varunsunkara15/Nexus_drive/hardware/nexus_drive.kicad_pcb

## KiCad design hardware/nexus_drive.kicad_pcb (2026-11-03)

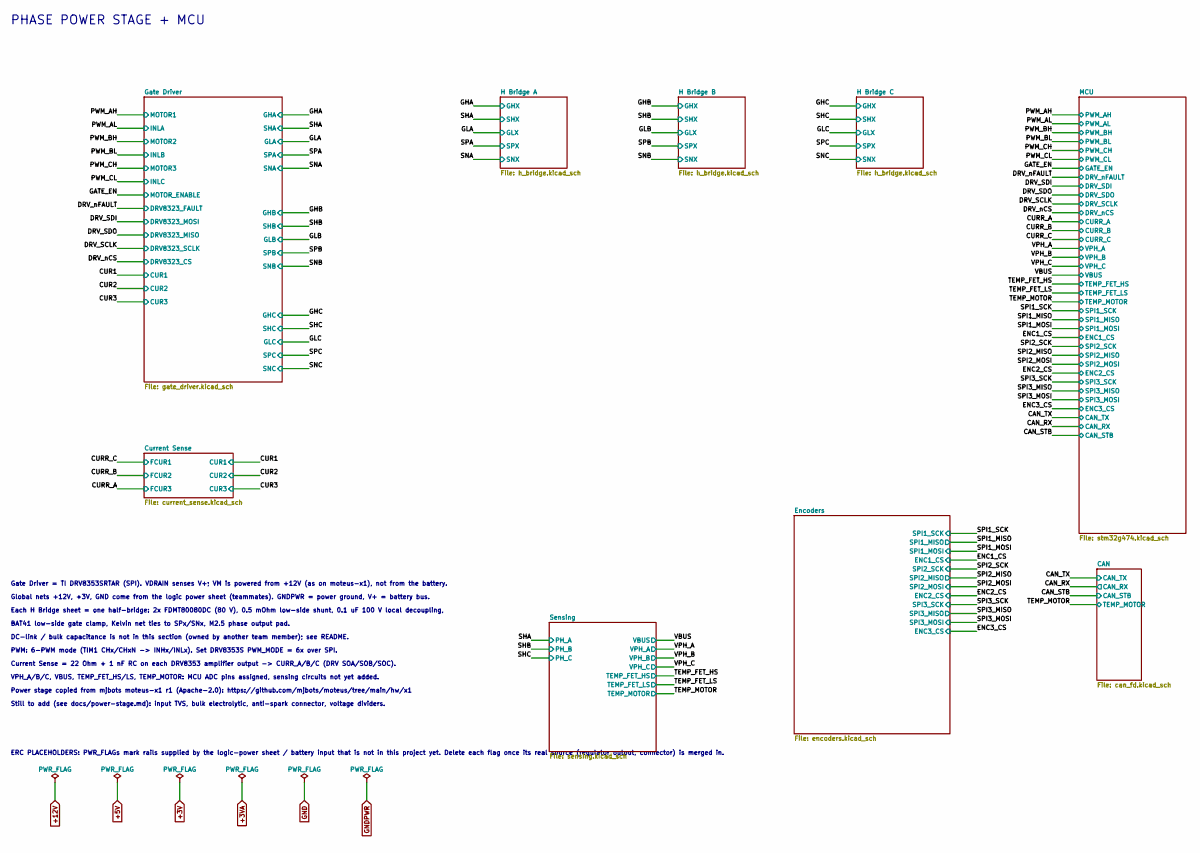
[picture p1: schematic nexus_drive.kicad_sch, Nexus Drive]

Notes on the sheet:
PWM: 6-PWM mode (TIM1 CHx/CHxN -> INHx/INLx). Set DRV8353S PWM_MODE = 6x over SPI.
Each H Bridge sheet = one half-bridge: 2x FDMT80080DC (80 V), 0.5 mOhm low-side shunt, 0.1 uF 100 V local decoupling,
Global nets +12V, +3V, GND come from the logic power sheet (teammates). GNDPWR = power ground, V+ = battery bus.
Gate Driver = TI DRV8353SRTAR (SPI). VDRAIN senses V+; VM is powered from +12V (as on moteus-x1), not from the battery.
DC-link / bulk capacitance is not in this section (owned by another team member); see README.
BAT41 low-side gate clamp, Kelvin net ties to SPx/SNx, M2.5 phase output pad.
Power stage copied from mjbots moteus-x1 r1 (Apache-2.0): https://github.com/mjbots/moteus/tree/main/hw/x1
Current Sense = 22 Ohm + 1 nF RC on each DRV8353 amplifier output -> CURR_A/B/C (DRV SOA/SOB/SOC).
ERC PLACEHOLDERS: PWR_FLAGs mark rails supplied by the logic-power sheet / battery input that is not in this project yet. Delete each flag once its real source (regulator output, connector) is merged in.
PHASE POWER STAGE + MCU
VPH_A/B/C, VBUS, TEMP_FET_HS/LS, TEMP_MOTOR: MCU ADC pins assigned, sensing circuits not yet added.
Still to add (see docs/power-stage.md): input TVS, bulk electrolytic, anti-spark connector, voltage dividers.

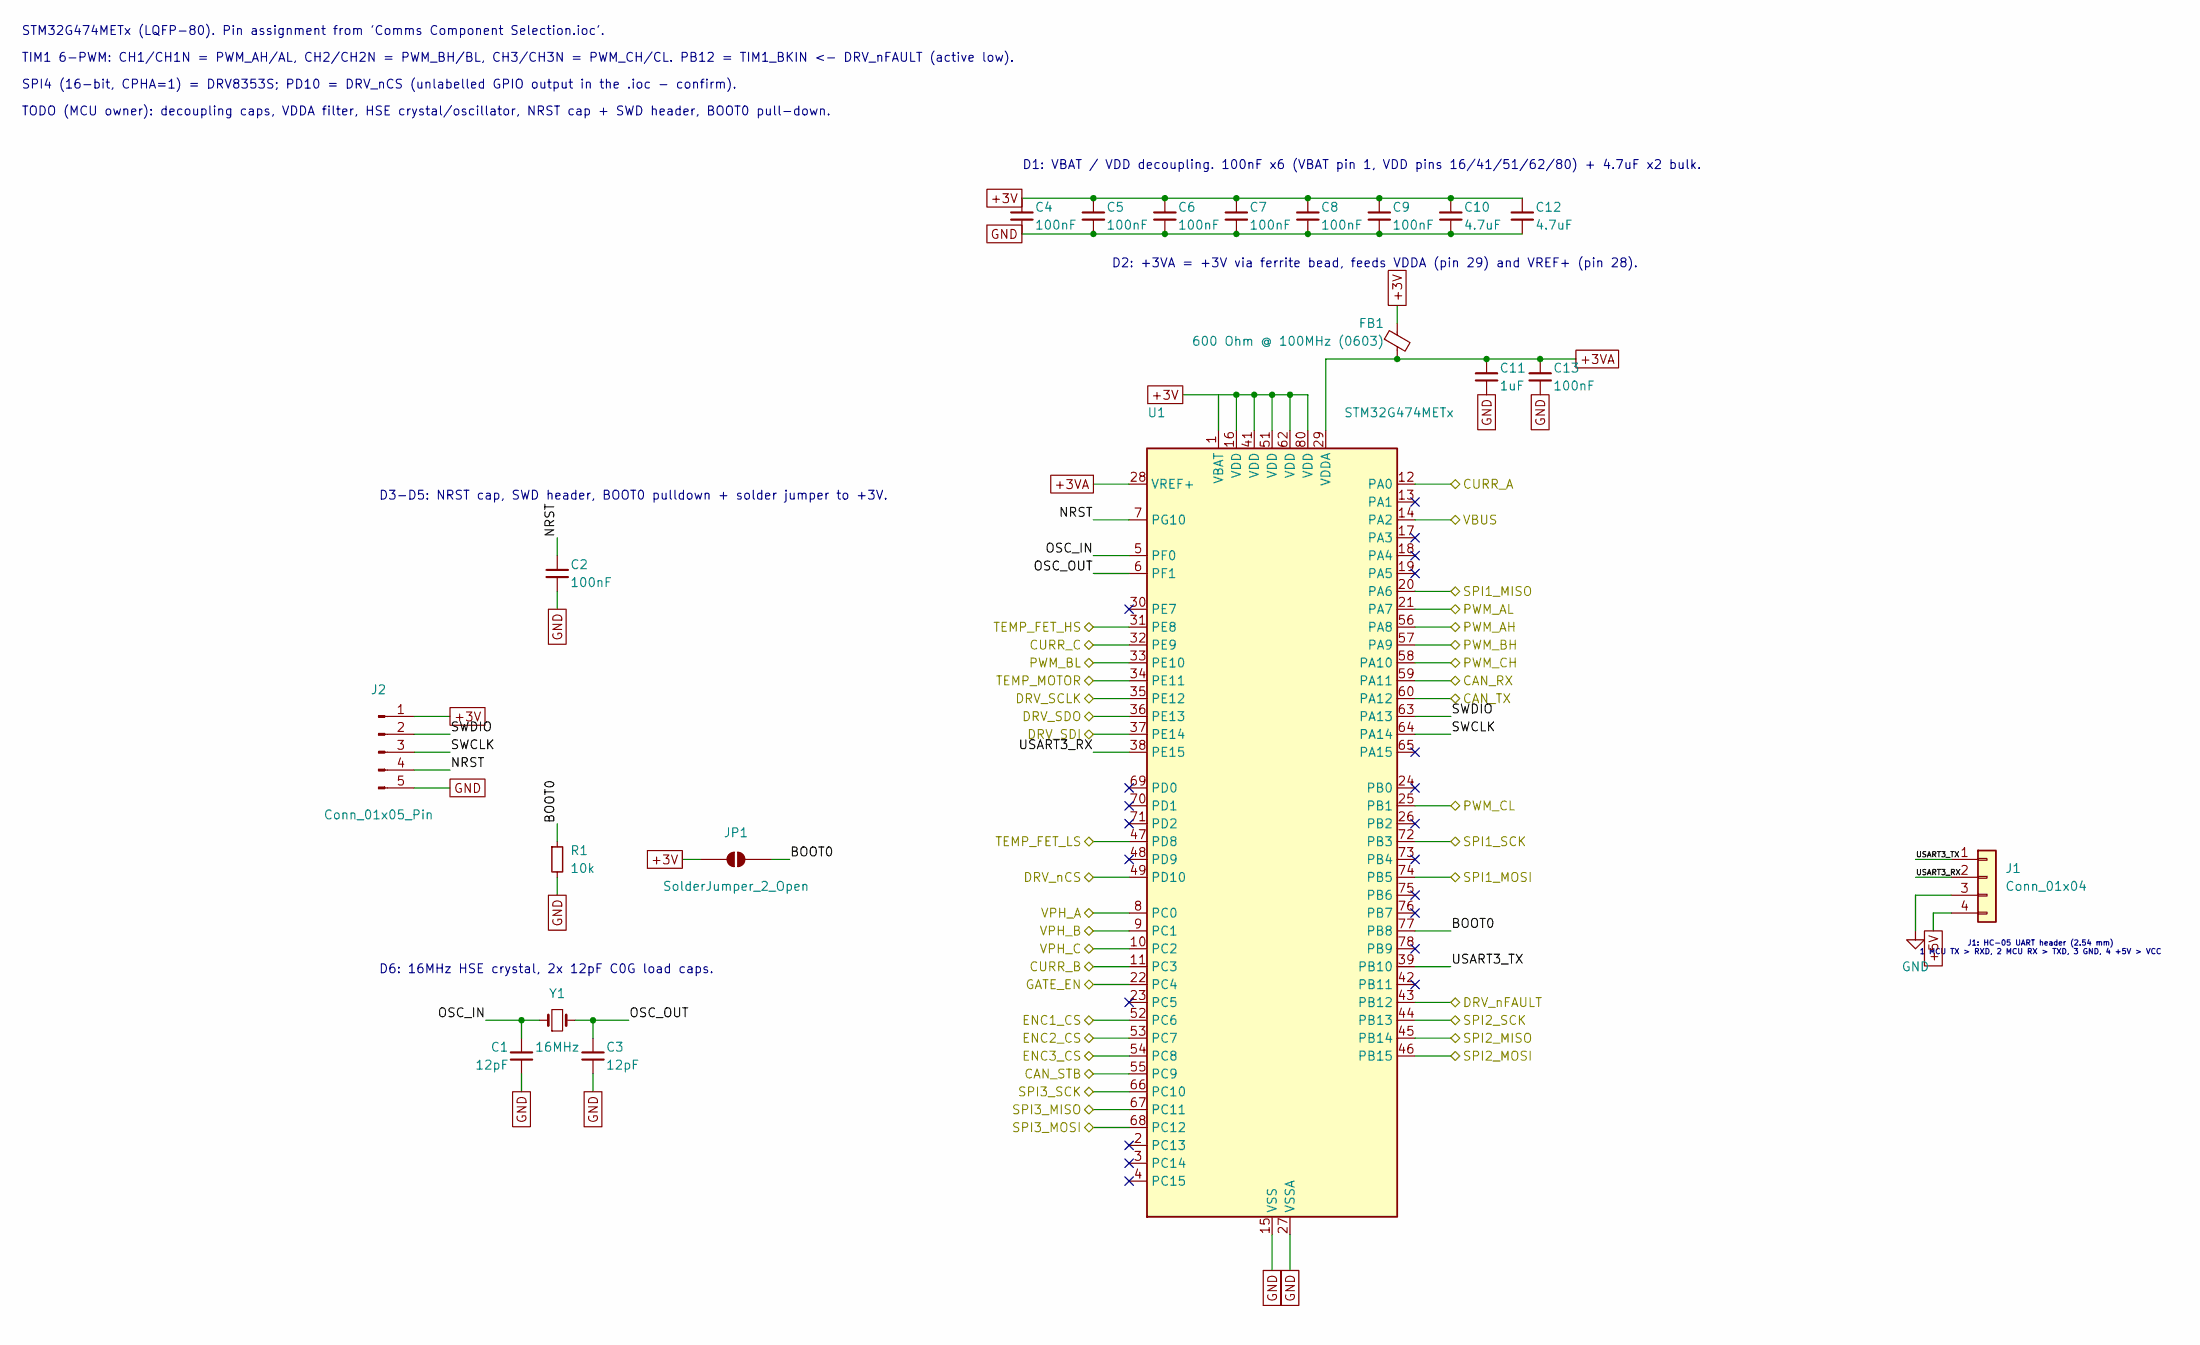
[picture p2: schematic stm32g474.kicad_sch, Nexus Drive - MCU (STM32G474METx)]

Parts:
C1, C3: 12pF; C_0603_1608Metric
C2, C4, C5, C6, C7, C8, C9, C13: 100nF; C_0603_1608Metric
C10, C12: 4.7uF; C_0805_2012Metric
C11: 1uF; C_0603_1608Metric
FB1: 600 Ohm @ 100MHz (0603); L_0603_1608Metric
J1: Conn_01x04; PinHeader_1x04_P2.54mm_Vertical
J2: Conn_01x05_Pin; PinHeader_1x05_P1.27mm_Vertical
JP1: SolderJumper_2_Open; SolderJumper-2_P1.3mm_Open_Pad1.0x1.5mm
R1: 10k; R_0603_1608Metric
U1: STM32G474METx; LQFP-80_12x12mm_P0.5mm
Y1: 16MHz; Crystal_SMD_5032-2Pin_5.0x3.2mm; MPN ABM8-16.000MHZ-10-1-U-T

Connections:
+3V: C4.1, C5.1, C6.1, C7.1, C8.1, C9.1, C10.1, C12.1, FB1.1, J2.1, JP1.1 (A), U1.1 (VBAT), U1.16 (VDD), U1.41 (VDD), U1.51 (VDD), U1.62 (VDD), U1.80 (VDD); also elsewhere on the board
+3VA: C11.1, C13.1, FB1.2, U1.28 (VREF+), U1.29 (VDDA); also elsewhere on the board
+5V: J1.4; also elsewhere on the board
/CAN_RX: U1.59 (PA11); also elsewhere on the board
/CAN_STB: U1.55 (PC9); also elsewhere on the board
/CAN_TX: U1.60 (PA12); also elsewhere on the board
/CURR_A: U1.12 (PA0); also elsewhere on the board
/CURR_B: U1.11 (PC3); also elsewhere on the board
/CURR_C: U1.32 (PE9); also elsewhere on the board
/DRV_SCLK: U1.35 (PE12); also elsewhere on the board
/DRV_SDI: U1.37 (PE14); also elsewhere on the board
/DRV_SDO: U1.36 (PE13); also elsewhere on the board
/DRV_nCS: U1.49 (PD10); also elsewhere on the board
/DRV_nFAULT: U1.43 (PB12); also elsewhere on the board
/ENC1_CS: U1.52 (PC6); also elsewhere on the board
/ENC2_CS: U1.53 (PC7); also elsewhere on the board
/ENC3_CS: U1.54 (PC8); also elsewhere on the board
/GATE_EN: U1.22 (PC4); also elsewhere on the board
/MCU/BOOT0: JP1.2 (B), R1.1, U1.77 (PB8)
/MCU/NRST: C2.1, J2.4, U1.7 (PG10)
/MCU/OSC_IN: C1.1, U1.5 (PF0), Y1.1
/MCU/OSC_OUT: C3.1, U1.6 (PF1), Y1.2
/MCU/SWCLK: J2.3, U1.64 (PA14)
/MCU/SWDIO: J2.2, U1.63 (PA13)
/MCU/USART3_RX: J1.2, U1.38 (PE15)
/MCU/USART3_TX: J1.1, U1.39 (PB10)
/PWM_AH: U1.56 (PA8); also elsewhere on the board
/PWM_AL: U1.21 (PA7); also elsewhere on the board
/PWM_BH: U1.57 (PA9); also elsewhere on the board
/PWM_BL: U1.33 (PE10); also elsewhere on the board
/PWM_CH: U1.58 (PA10); also elsewhere on the board
/PWM_CL: U1.25 (PB1); also elsewhere on the board
/SPI1_MISO: U1.20 (PA6); also elsewhere on the board
/SPI1_MOSI: U1.74 (PB5); also elsewhere on the board
/SPI1_SCK: U1.72 (PB3); also elsewhere on the board
/SPI2_MISO: U1.45 (PB14); also elsewhere on the board
/SPI2_MOSI: U1.46 (PB15); also elsewhere on the board
/SPI2_SCK: U1.44 (PB13); also elsewhere on the board
/SPI3_MISO: U1.67 (PC11); also elsewhere on the board
/SPI3_MOSI: U1.68 (PC12); also elsewhere on the board
/SPI3_SCK: U1.66 (PC10); also elsewhere on the board
/TEMP_FET_HS: U1.31 (PE8); also elsewhere on the board
/TEMP_FET_LS: U1.47 (PD8); also elsewhere on the board
/TEMP_MOTOR: U1.34 (PE11); also elsewhere on the board
/VBUS: U1.14 (PA2); also elsewhere on the board
/VPH_A: U1.8 (PC0); also elsewhere on the board
/VPH_B: U1.9 (PC1); also elsewhere on the board
/VPH_C: U1.10 (PC2); also elsewhere on the board
GND: C1.2, C2.2, C3.2, C4.2, C5.2, C6.2, C7.2, C8.2, C9.2, C10.2, C11.2, C12.2, C13.2, J1.3, J2.5, R1.2, U1.15 (VSS), U1.27 (VSSA), U1.40 (VSS), U1.50 (VSS), U1.61 (VSS), U1.79 (VSS); also elsewhere on the board

Notes on the sheet:
D2: +3VA = +3V via ferrite bead, feeds VDDA (pin 29) and VREF+ (pin 28).
J1: HC-05 UART header (2.54 mm) 1 MCU TX > RXD, 2 MCU RX > TXD, 3 GND, 4 +5V > VCC
TODO (MCU owner): decoupling caps, VDDA filter, HSE crystal/oscillator, NRST cap + SWD header, BOOT0 pull-down.
SPI4 (16-bit, CPHA=1) = DRV8353S; PD10 = DRV_nCS (unlabelled GPIO output in the .ioc - confirm).
D1: VBAT / VDD decoupling. 100nF x6 (VBAT pin 1, VDD pins 16/41/51/62/80) + 4.7uF x2 bulk.
D6: 16MHz HSE crystal, 2x 12pF C0G load caps.
STM32G474METx (LQFP-80). Pin assignment from 'Comms Component Selection.ioc'.
TIM1 6-PWM: CH1/CH1N = PWM_AH/AL, CH2/CH2N = PWM_BH/BL, CH3/CH3N = PWM_CH/CL. PB12 = TIM1_BKIN <- DRV_nFAULT (active low).
D3-D5: NRST cap, SWD header, BOOT0 pulldown + solder jumper to +3V.

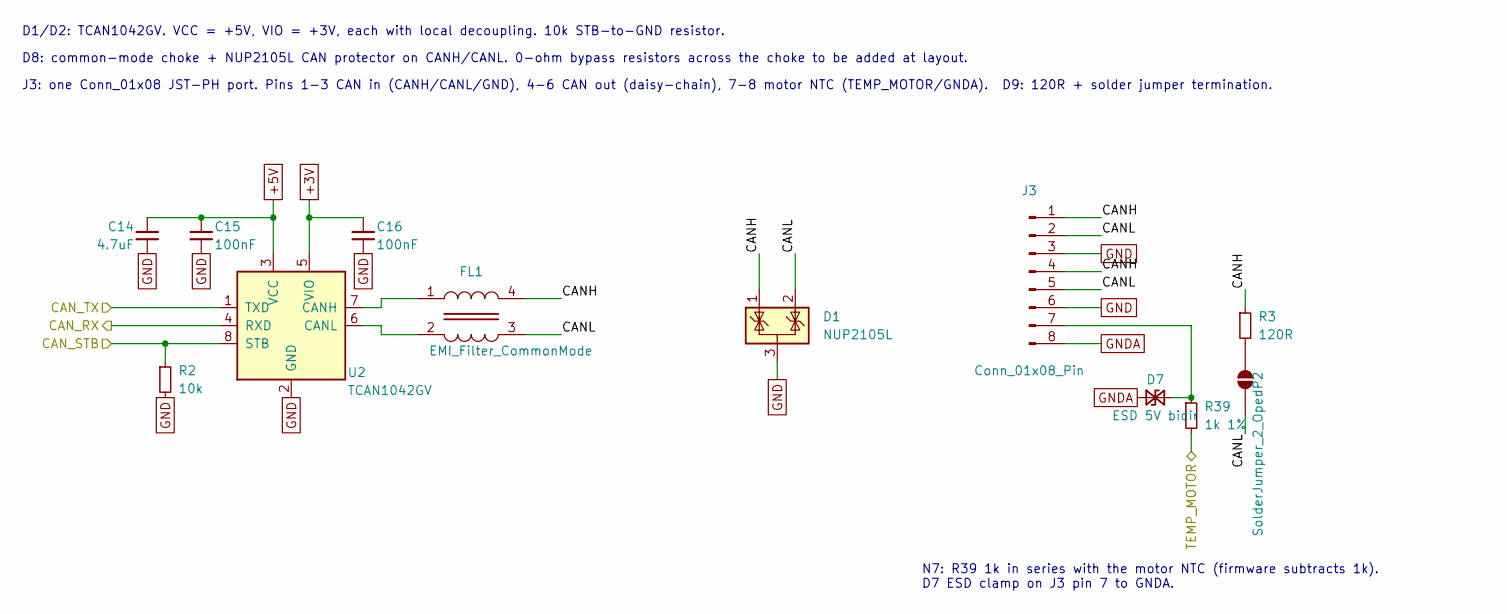
[picture p3: schematic can_fd.kicad_sch]

Parts:
C14: 4.7uF; C_0805_2012Metric
C15, C16: 100nF; C_0603_1608Metric
D1: NUP2105L; SOT-23
D7: ESD 5V bidir; D_SOD-323
FL1: EMI_Filter_CommonMode; L_CommonMode_TDK_ACT1210D
J3: Conn_01x08_Pin; JST_PH_B8B-PH-K_1x08_P2.00mm_Vertical
JP2: SolderJumper_2_Open; SolderJumper-2_P1.3mm_Open_Pad1.0x1.5mm
R2: 10k; R_0603_1608Metric
R3: 120R; R_0603_1608Metric
R39: 1k 1%; R_0603_1608Metric
U2: TCAN1042GV; SOIC-8_3.9x4.9mm_P1.27mm

Connections:
+3V: C16.1, U2.5 (VIO); also elsewhere on the board
+5V: C14.1, C15.1, U2.3 (VCC); also elsewhere on the board
/CAN/CANH: D1.1 (K), FL1.4, J3.1, J3.4, R3.1
/CAN/CANL: D1.2 (K), FL1.3, J3.2, J3.5, JP2.2 (B)
/CAN_RX: U2.4 (RXD); also elsewhere on the board
/CAN_STB: R2.1, U2.8 (STB); also elsewhere on the board
/CAN_TX: U2.1 (TXD); also elsewhere on the board
/TEMP_MOTOR: R39.2; also elsewhere on the board
GND: C14.2, C15.2, C16.2, D1.3 (A), J3.3, J3.6, R2.2, U2.2 (GND); also elsewhere on the board
GNDA: D7.1 (A1), J3.8; also elsewhere on the board
unnamed: D7.2 (A2), J3.7, R39.1
unnamed: JP2.1 (A), R3.2
unnamed: FL1.1, U2.7 (CANH)
unnamed: FL1.2, U2.6 (CANL)

Notes on the sheet:
D8: common-mode choke + NUP2105L CAN protector on CANH/CANL. 0-ohm bypass resistors across the choke to be added at layout.
D1/D2: TCAN1042GV. VCC = +5V, VIO = +3V, each with local decoupling. 10k STB-to-GND resistor.
J3: one Conn_01x08 JST-PH port. Pins 1-3 CAN in (CANH/CANL/GND), 4-6 CAN out (daisy-chain), 7-8 motor NTC (TEMP_MOTOR/GNDA). D9: 120R + solder jumper termination.
N7: R39 1k in series with the motor NTC (firmware subtracts 1k). D7 ESD clamp on J3 pin 7 to GNDA.

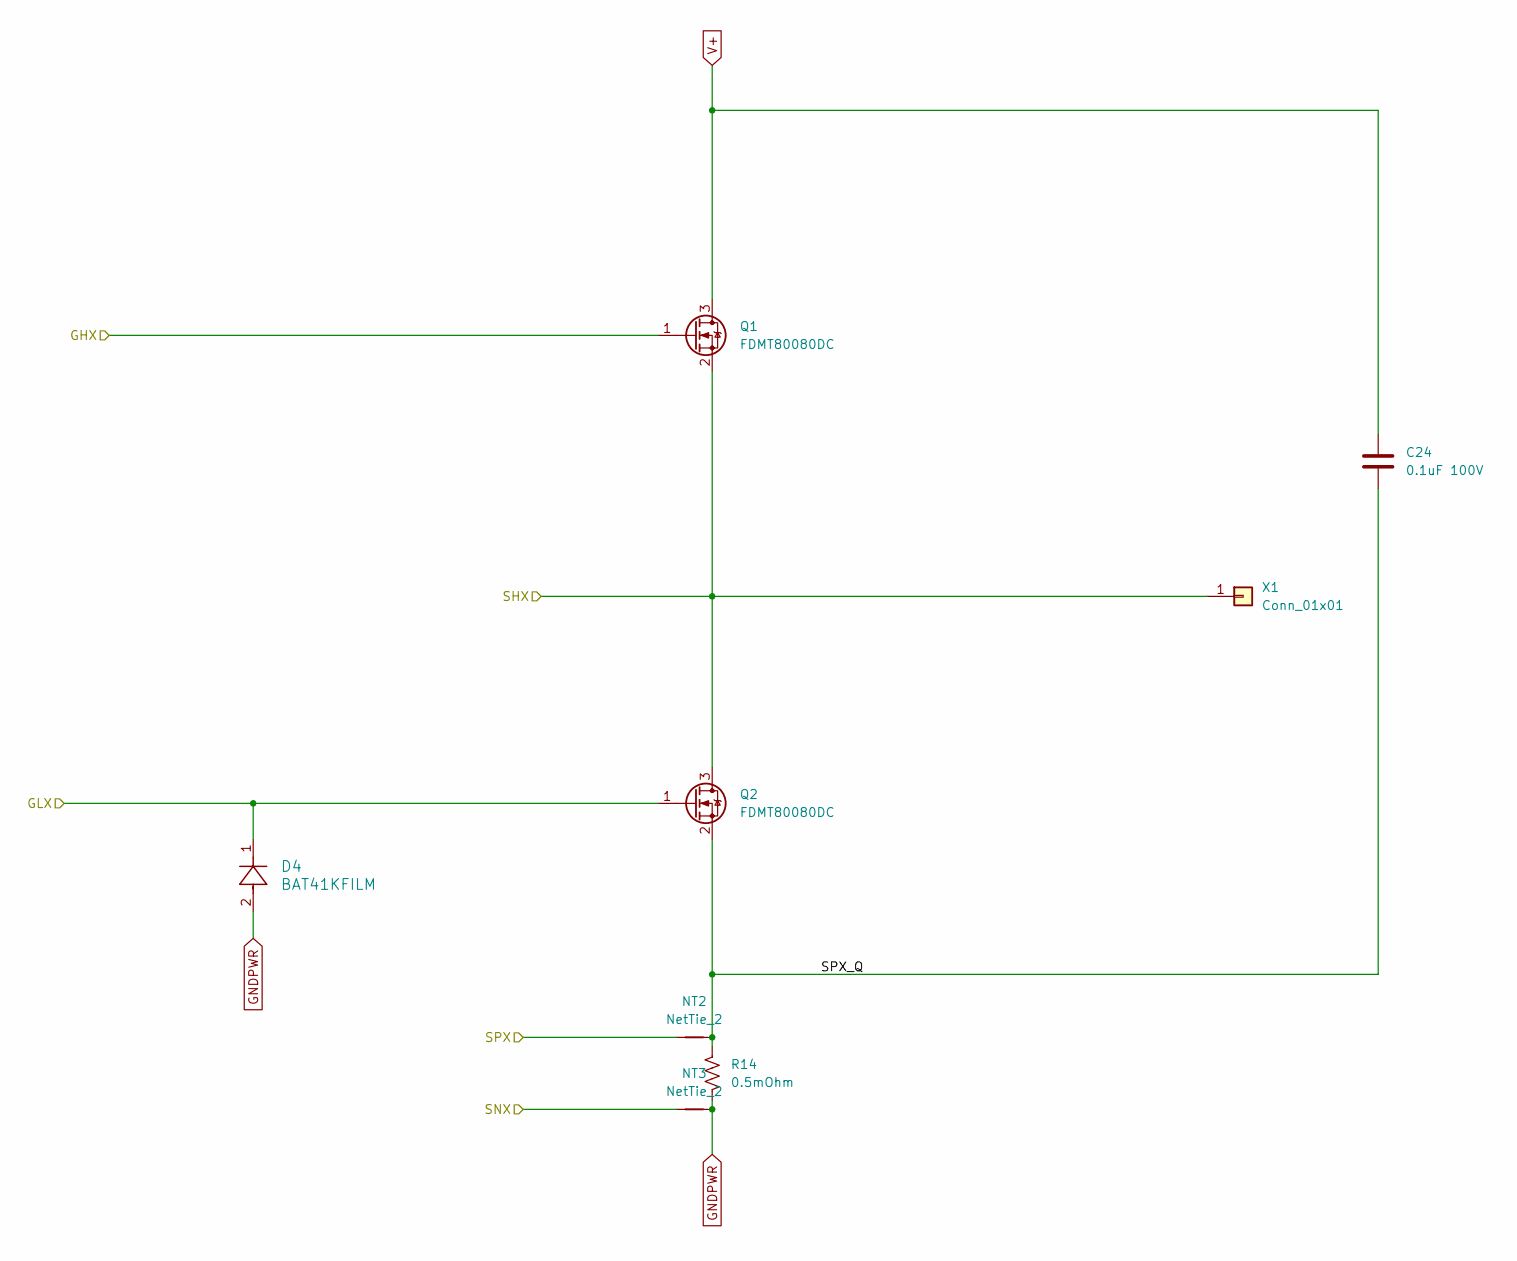
[picture p4: schematic h_bridge.kicad_sch, Nexus Drive - Half Bridge (phase power)]

Parts:
C24: 0.1uF 100V; C_1812_4532Metric; MPN 18121C104MAT2A
D4: BAT41KFILM; SOD-523_STM; MPN BAT41KFILM
NT2, NT3: NetTie_2; NetTie-2_SMD_Pad0.2
Q1, Q2: FDMT80080DC; PQFN_8x8; MPN FDMT80080DC
R14: 0.5mOhm; R_2512_6332Metric; MPN WSLF2512L5000FEA
X1: Conn_01x01; POWER_M2.5

Connections:
/GHA: Q1.1 (G); also elsewhere on the board
/GLA: D4.1, Q2.1 (G); also elsewhere on the board
/H Bridge A/SPX_Q: C24.2, NT2.2, Q2.2 (S), R14.1
/SHA: Q1.2 (S), Q2.3 (D), X1.1 (Pin_1_1); also elsewhere on the board
/SNA: NT3.1; also elsewhere on the board
/SPA: NT2.1; also elsewhere on the board
GNDPWR: D4.2, NT3.2, R14.2; also elsewhere on the board
V+: C24.1, Q1.3 (D); also elsewhere on the board

Parts of its further copies:
C25, C26: 0.1uF 100V; C_1812_4532Metric; MPN 18121C104MAT2A
D5, D6: BAT41KFILM; SOD-523_STM; MPN BAT41KFILM
NT4, NT5, NT6, NT7: NetTie_2; NetTie-2_SMD_Pad0.2
Q3, Q4, Q5, Q6: FDMT80080DC; PQFN_8x8; MPN FDMT80080DC
R15, R16: 0.5mOhm; R_2512_6332Metric; MPN WSLF2512L5000FEA
X2, X3: Conn_01x01; POWER_M2.5

Connections of its further copies:
/GHB: Q3.1 (G); also elsewhere on the board
/GHC: Q5.1 (G); also elsewhere on the board
/GLB: D5.1, Q4.1 (G); also elsewhere on the board
/GLC: D6.1, Q6.1 (G); also elsewhere on the board
/H Bridge B/SPX_Q: C25.2, NT4.2, Q4.2 (S), R15.1
/H Bridge C/SPX_Q: C26.2, NT6.2, Q6.2 (S), R16.1
/SHB: Q3.2 (S), Q4.3 (D), X2.1 (Pin_1_1); also elsewhere on the board
/SHC: Q5.2 (S), Q6.3 (D), X3.1 (Pin_1_1); also elsewhere on the board
/SNB: NT5.1; also elsewhere on the board
/SNC: NT7.1; also elsewhere on the board
/SPB: NT4.1; also elsewhere on the board
/SPC: NT6.1; also elsewhere on the board
GNDPWR: D5.2, D6.2, NT5.2, NT7.2, R15.2, R16.2; also elsewhere on the board
V+: C25.1, C26.1, Q3.3 (D), Q5.3 (D); also elsewhere on the board

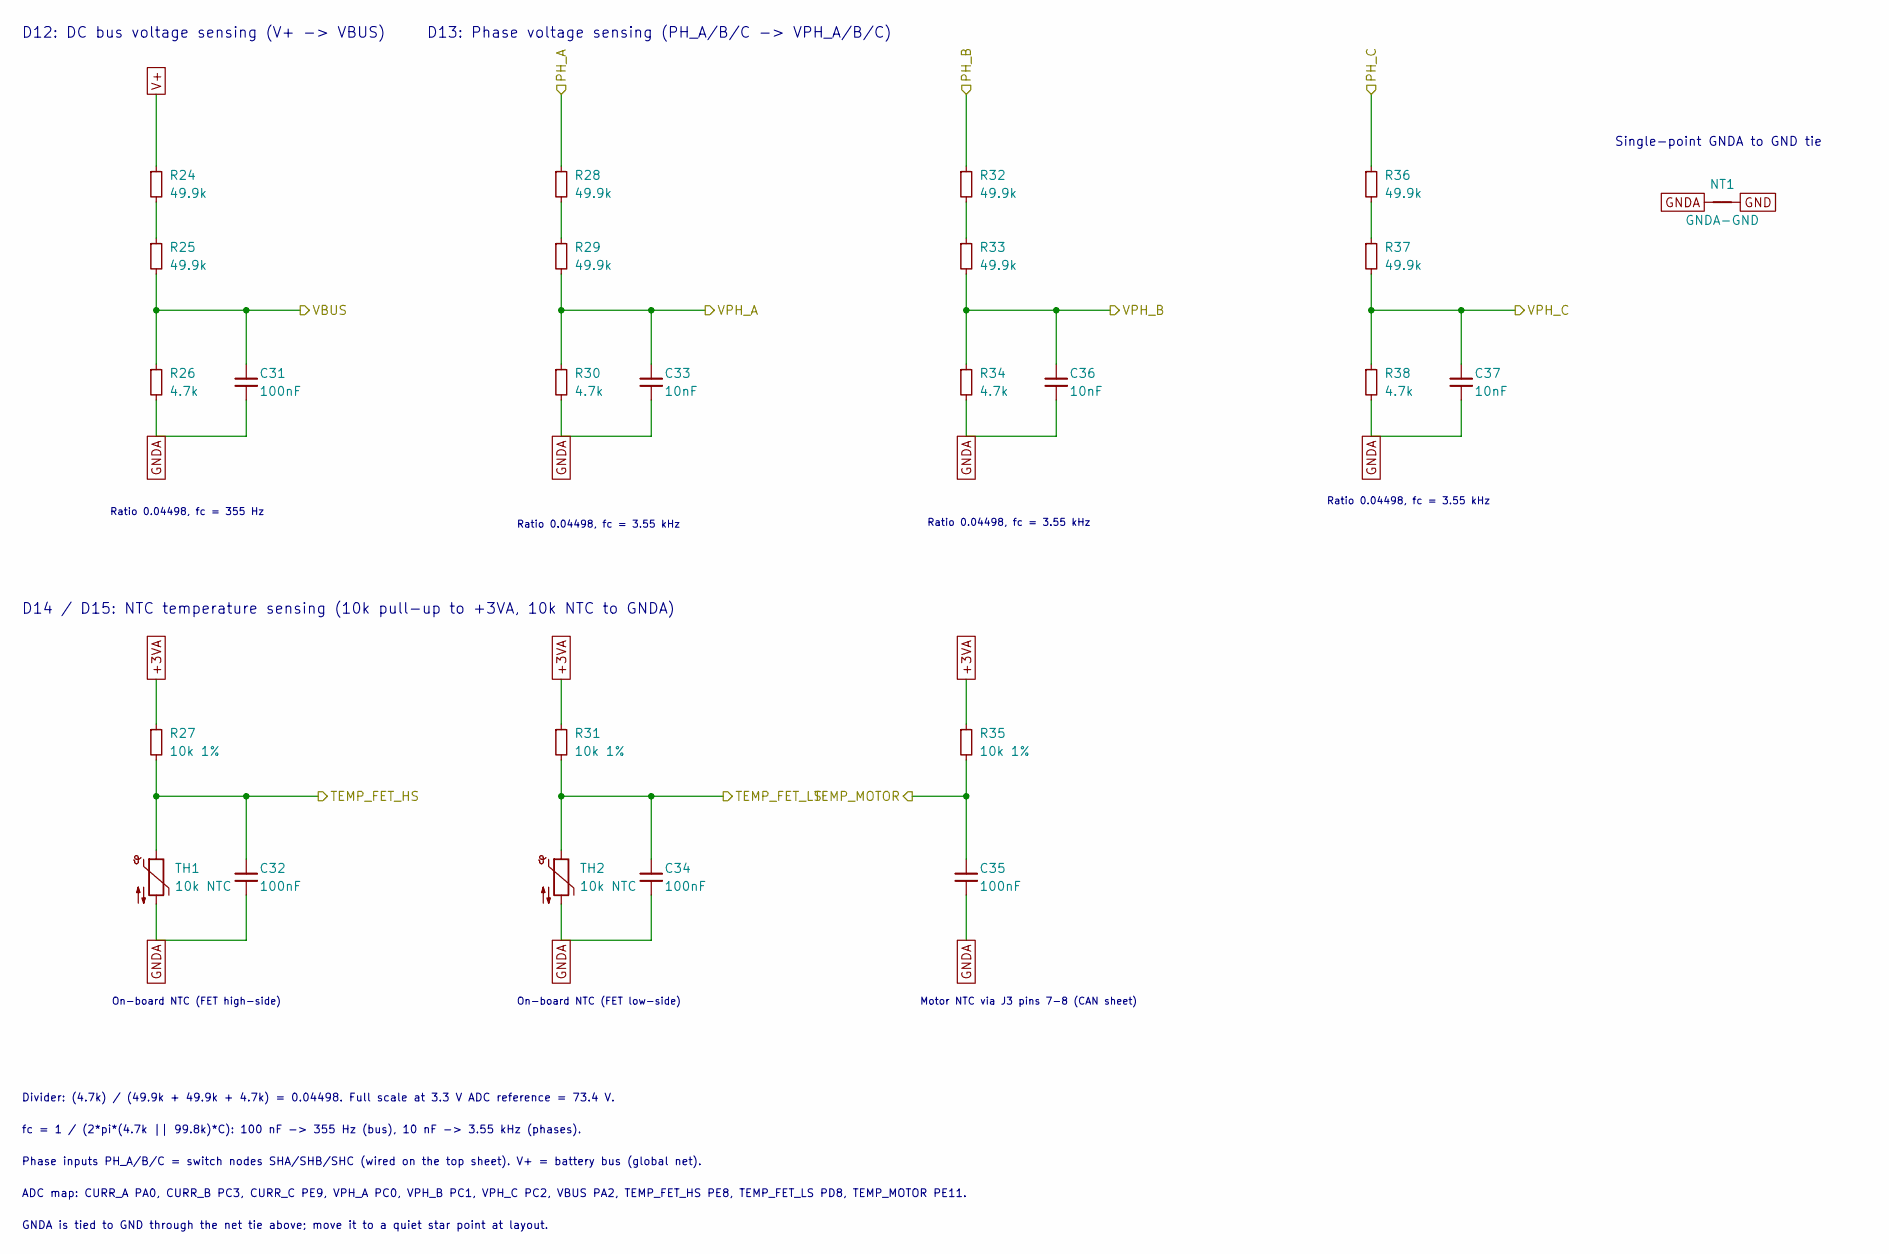
[picture p5: schematic sensing.kicad_sch, Nexus Drive - Sensing]

Parts:
C31, C32, C34, C35: 100nF; C_0603_1608Metric
C33, C36, C37: 10nF; C_0603_1608Metric
NT1: GNDA-GND; NetTie-2_SMD_Pad0.5mm
R24, R25, R28, R29, R32, R33, R36, R37: 49.9k; R_0805_2012Metric
R26, R30, R34, R38: 4.7k; R_0603_1608Metric
R27, R31, R35: 10k 1%; R_0603_1608Metric
TH1, TH2: 10k NTC; R_0603_1608Metric

Connections:
+3VA: R27.1, R31.1, R35.1; also elsewhere on the board
/SHA: R28.1; also elsewhere on the board
/SHB: R32.1; also elsewhere on the board
/SHC: R36.1; also elsewhere on the board
/TEMP_FET_HS: C32.1, R27.2, TH1.1; also elsewhere on the board
/TEMP_FET_LS: C34.1, R31.2, TH2.1; also elsewhere on the board
/TEMP_MOTOR: C35.1, R35.2; also elsewhere on the board
/VBUS: C31.1, R25.2, R26.1; also elsewhere on the board
/VPH_A: C33.1, R29.2, R30.1; also elsewhere on the board
/VPH_B: C36.1, R33.2, R34.1; also elsewhere on the board
/VPH_C: C37.1, R37.2, R38.1; also elsewhere on the board
GND: NT1.2; also elsewhere on the board
GNDA: C31.2, C32.2, C33.2, C34.2, C35.2, C36.2, C37.2, NT1.1, R26.2, R30.2, R34.2, R38.2, TH1.2, TH2.2; also elsewhere on the board
unnamed: R24.2, R25.1
unnamed: R28.2, R29.1
unnamed: R32.2, R33.1
unnamed: R36.2, R37.1
V+: R24.1; also elsewhere on the board

Notes on the sheet:
Phase inputs PH_A/B/C = switch nodes SHA/SHB/SHC (wired on the top sheet). V+ = battery bus (global net).
Ratio 0.04498, fc = 355 Hz
Motor NTC via J3 pins 7-8 (CAN sheet)
D14 / D15: NTC temperature sensing (10k pull-up to +3VA, 10k NTC to GNDA)
On-board NTC (FET high-side)
Ratio 0.04498, fc = 3.55 kHz
GNDA is tied to GND through the net tie above; move it to a quiet star point at layout.
Single-point GNDA to GND tie
D12: DC bus voltage sensing (V+ -> VBUS)
D13: Phase voltage sensing (PH_A/B/C -> VPH_A/B/C)
ADC map: CURR_A PA0, CURR_B PC3, CURR_C PE9, VPH_A PC0, VPH_B PC1, VPH_C PC2, VBUS PA2, TEMP_FET_HS PE8, TEMP_FET_LS PD8, TEMP_MOTOR PE11.
Divider: (4.7k) / (49.9k + 49.9k + 4.7k) = 0.04498. Full scale at 3.3 V ADC reference = 73.4 V.
On-board NTC (FET low-side)
fc = 1 / (2*pi*(4.7k || 99.8k)*C): 100 nF -> 355 Hz (bus), 10 nF -> 3.55 kHz (phases).

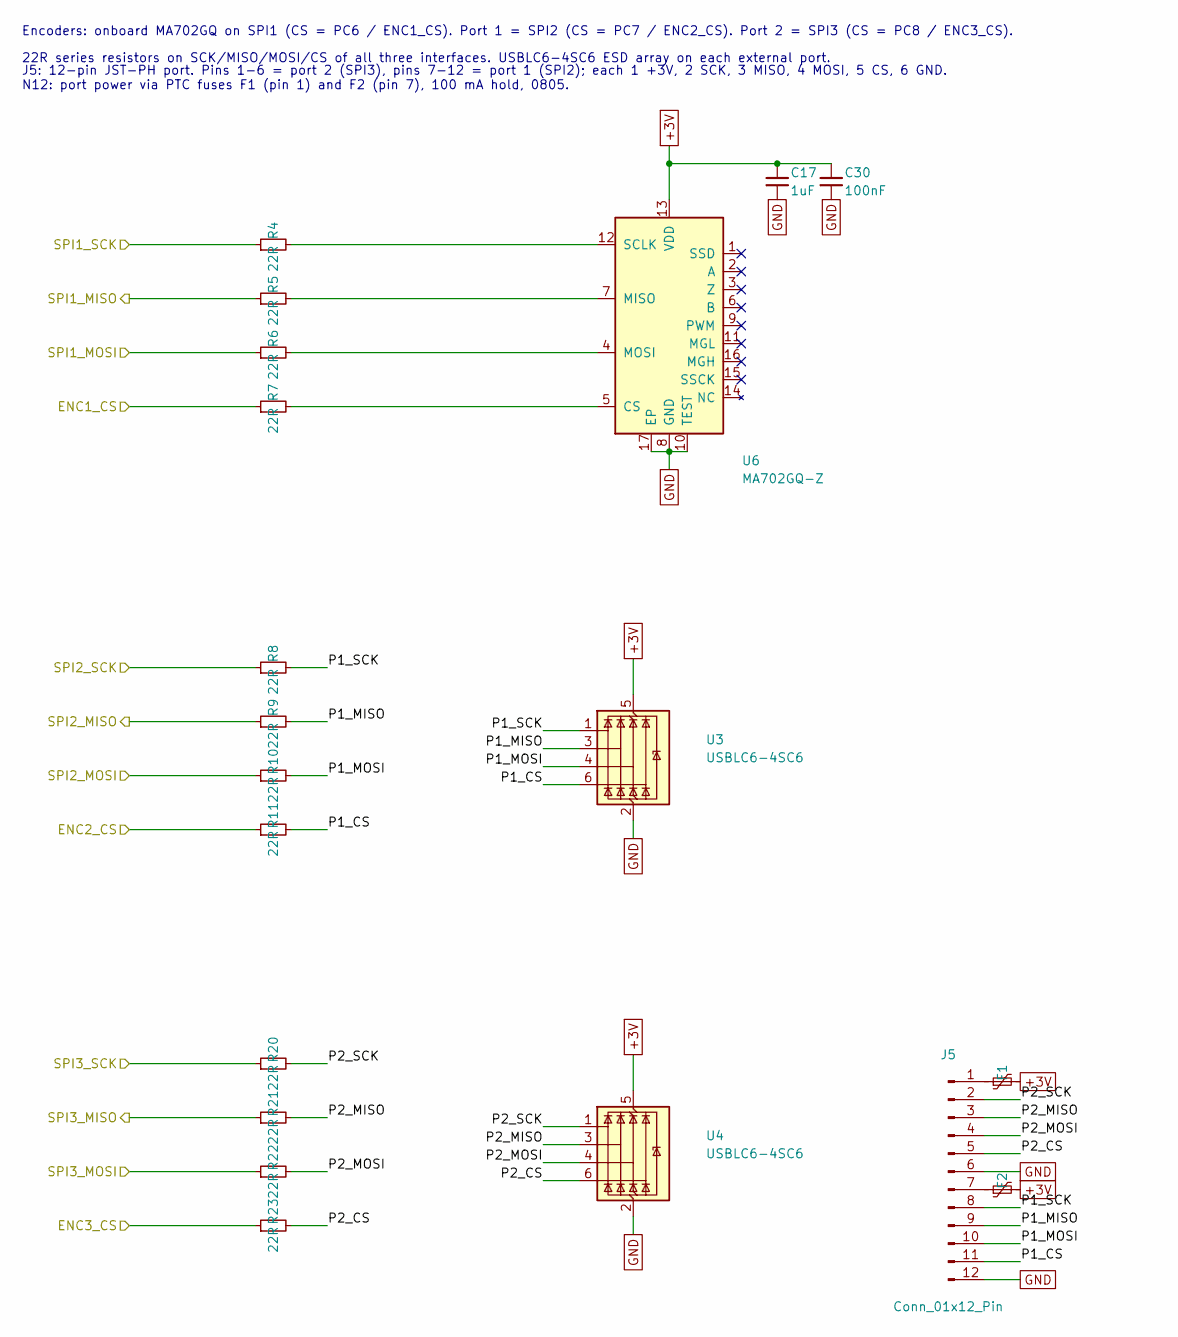
[picture p6: schematic encoders.kicad_sch]

Parts:
C17: 1uF; C_0603_1608Metric
C30: 100nF; C_0603_1608Metric
F1, F2: PTC 100mA hold; Fuse_0805_2012Metric
J5: Conn_01x12_Pin; JST_PH_B12B-PH-K_1x12_P2.00mm_Vertical
R4, R5, R6, R7, R8, R9, R10, R11, R20, R21, R22, R23: 22R; R_0603_1608Metric
U3, U4: USBLC6-4SC6; SOT-23-6
U6: MA702GQ-Z; QFN-16-1EP_3x3mm_P0.5mm_EP1.7x1.7mm

Connections:
+3V: C17.1, C30.1, F1.2, F2.2, U3.5 (VBUS), U4.5 (VBUS), U6.13 (VDD); also elsewhere on the board
/ENC1_CS: R7.1; also elsewhere on the board
/ENC2_CS: R11.1; also elsewhere on the board
/ENC3_CS: R23.1; also elsewhere on the board
/Encoders/P1_CS: J5.11, R11.2, U3.6 (I/O4)
/Encoders/P1_MISO: J5.9, R9.2, U3.3 (I/O2)
/Encoders/P1_MOSI: J5.10, R10.2, U3.4 (I/O3)
/Encoders/P1_SCK: J5.8, R8.2, U3.1 (I/O1)
/Encoders/P2_CS: J5.5, R23.2, U4.6 (I/O4)
/Encoders/P2_MISO: J5.3, R21.2, U4.3 (I/O2)
/Encoders/P2_MOSI: J5.4, R22.2, U4.4 (I/O3)
/Encoders/P2_SCK: J5.2, R20.2, U4.1 (I/O1)
/SPI1_MISO: R5.1; also elsewhere on the board
/SPI1_MOSI: R6.1; also elsewhere on the board
/SPI1_SCK: R4.1; also elsewhere on the board
/SPI2_MISO: R9.1; also elsewhere on the board
/SPI2_MOSI: R10.1; also elsewhere on the board
/SPI2_SCK: R8.1; also elsewhere on the board
/SPI3_MISO: R21.1; also elsewhere on the board
/SPI3_MOSI: R22.1; also elsewhere on the board
/SPI3_SCK: R20.1; also elsewhere on the board
GND: C17.2, C30.2, J5.6, J5.12, U3.2 (GND), U4.2 (GND), U6.8 (GND), U6.10 (TEST), U6.17 (EP); also elsewhere on the board
unnamed: F1.1, J5.1
unnamed: F2.1, J5.7
unnamed: R7.2, U6.5 (CS)
unnamed: R5.2, U6.7 (MISO)
unnamed: R6.2, U6.4 (MOSI)
unnamed: R4.2, U6.12 (SCLK)

Notes on the sheet:
J5: 12-pin JST-PH port. Pins 1-6 = port 2 (SPI3), pins 7-12 = port 1 (SPI2); each 1 +3V, 2 SCK, 3 MISO, 4 MOSI, 5 CS, 6 GND. N12: port power via PTC fuses F1 (pin 1) and F2 (pin 7), 100 mA hold, 0805.
22R series resistors on SCK/MISO/MOSI/CS of all three interfaces. USBLC6-4SC6 ESD array on each external port.
Encoders: onboard MA702GQ on SPI1 (CS = PC6 / ENC1_CS). Port 1 = SPI2 (CS = PC7 / ENC2_CS). Port 2 = SPI3 (CS = PC8 / ENC3_CS).

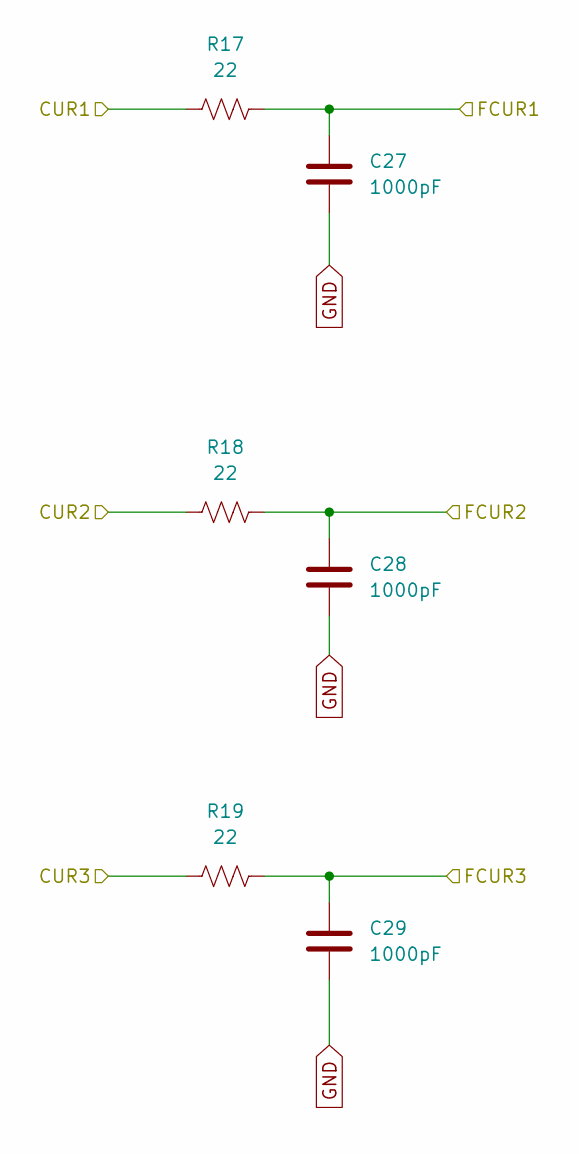
[picture p7: schematic current_sense.kicad_sch, Nexus Drive - Current Sense Output Filter]

Parts:
C27, C28, C29: 1000pF; C_0402_1005Metric; MPN MF-CAP-0402-1nF
R17, R18, R19: 22; R_0402_1005Metric; MPN MF-RES-0402-22

Connections:
/CUR1: R17.1; also elsewhere on the board
/CUR2: R18.1; also elsewhere on the board
/CUR3: R19.1; also elsewhere on the board
/CURR_A: C29.1, R19.2; also elsewhere on the board
/CURR_B: C28.1, R18.2; also elsewhere on the board
/CURR_C: C27.1, R17.2; also elsewhere on the board
GND: C27.2, C28.2, C29.2; also elsewhere on the board

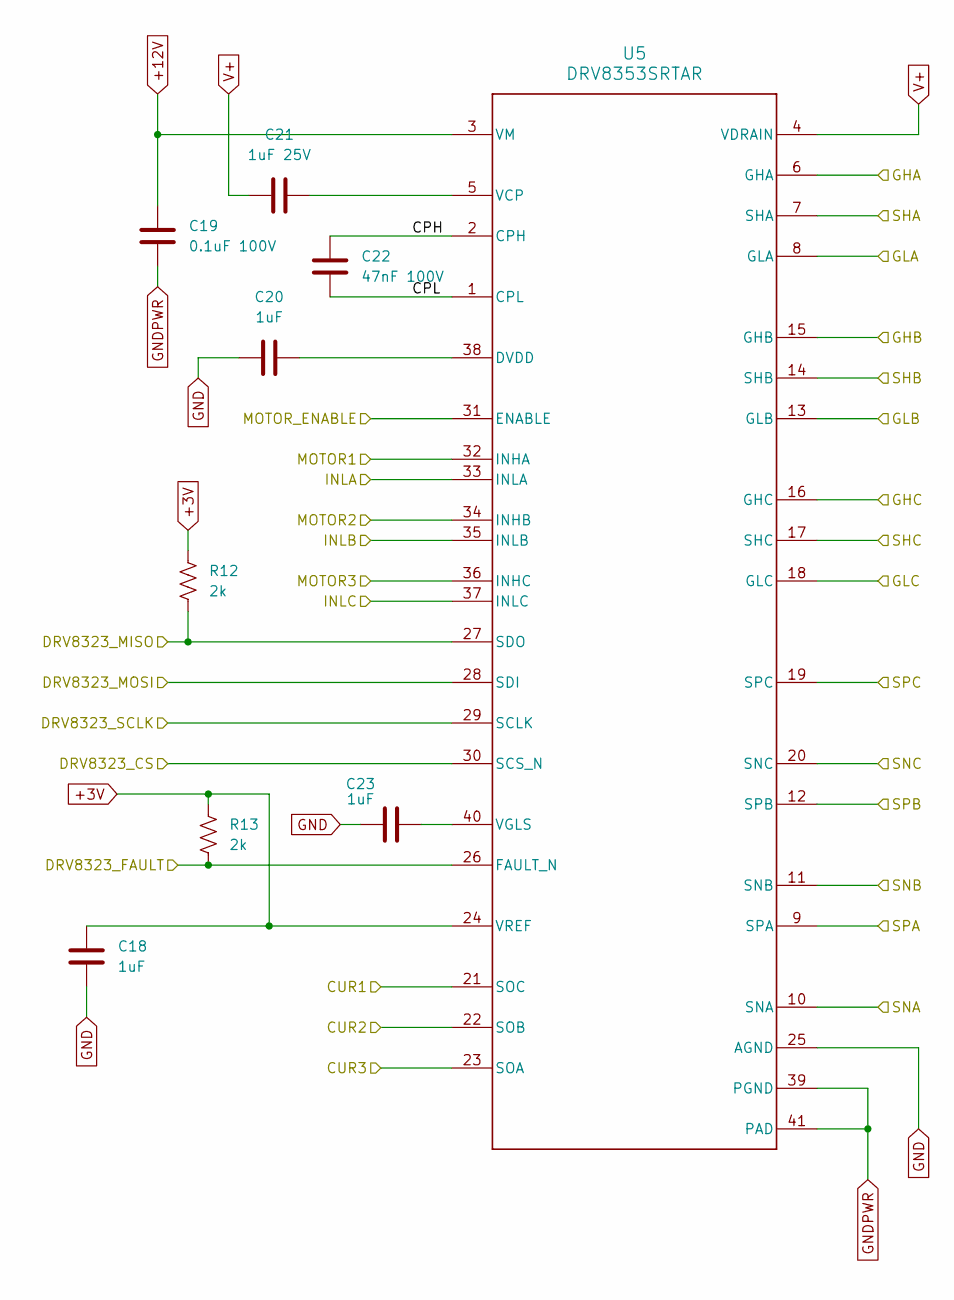
[picture p8: schematic gate_driver.kicad_sch, Nexus Drive - Gate Driver (DRV8353S)]

Parts:
C18: 1uF; C_0603_1608Metric; MPN MF-CAP-0603-1uF
C19: 0.1uF 100V; C_0603_1608Metric; MPN GCJ188R72A104KA01D
C20: 1uF; C_0402_1005Metric; MPN MF-CAP-0402-1uF
C21: 1uF 25V; C_0603_1608Metric; MPN C1608X7R1E105K080AE
C22: 47nF 100V; C_0603_1608Metric; MPN C0603X473K1RAC7867
C23: 1uF; C_0603_1608Metric; MPN C1608X7R1E105K080AE
R12, R13: 2k; R_0402_1005Metric; MPN MF-RES-0402-2K
U5: DRV8353SRTAR; RTA0040B; MPN DRV8353SRTAR

Connections:
+3V: C18.2, R12.1, R13.1, U5.24 (VREF); also elsewhere on the board
+12V: C19.2, U5.3 (VM)
/CUR1: U5.21 (SOC); also elsewhere on the board
/CUR2: U5.22 (SOB); also elsewhere on the board
/CUR3: U5.23 (SOA); also elsewhere on the board
/DRV_SCLK: U5.29 (SCLK); also elsewhere on the board
/DRV_SDI: U5.28 (SDI); also elsewhere on the board
/DRV_SDO: R12.2, U5.27 (SDO); also elsewhere on the board
/DRV_nCS: U5.30 (SCS_N); also elsewhere on the board
/DRV_nFAULT: R13.2, U5.26 (FAULT_N); also elsewhere on the board
/GATE_EN: U5.31 (ENABLE); also elsewhere on the board
/GHA: U5.6 (GHA); also elsewhere on the board
/GHB: U5.15 (GHB); also elsewhere on the board
/GHC: U5.16 (GHC); also elsewhere on the board
/GLA: U5.8 (GLA); also elsewhere on the board
/GLB: U5.13 (GLB); also elsewhere on the board
/GLC: U5.18 (GLC); also elsewhere on the board
/Gate Driver/CPH: C22.2, U5.2 (CPH)
/Gate Driver/CPL: C22.1, U5.1 (CPL)
/PWM_AH: U5.32 (INHA); also elsewhere on the board
/PWM_AL: U5.33 (INLA); also elsewhere on the board
/PWM_BH: U5.34 (INHB); also elsewhere on the board
/PWM_BL: U5.35 (INLB); also elsewhere on the board
/PWM_CH: U5.36 (INHC); also elsewhere on the board
/PWM_CL: U5.37 (INLC); also elsewhere on the board
/SHA: U5.7 (SHA); also elsewhere on the board
/SHB: U5.14 (SHB); also elsewhere on the board
/SHC: U5.17 (SHC); also elsewhere on the board
/SNA: U5.10 (SNA); also elsewhere on the board
/SNB: U5.11 (SNB); also elsewhere on the board
/SNC: U5.20 (SNC); also elsewhere on the board
/SPA: U5.9 (SPA); also elsewhere on the board
/SPB: U5.12 (SPB); also elsewhere on the board
/SPC: U5.19 (SPC); also elsewhere on the board
GND: C18.1, C20.1, C23.1, U5.25 (AGND); also elsewhere on the board
GNDPWR: C19.1, U5.39 (PGND), U5.41 (PAD); also elsewhere on the board
unnamed: C20.2, U5.38 (DVDD)
unnamed: C21.2, U5.5 (VCP)
unnamed: C23.2, U5.40 (VGLS)
V+: C21.1, U5.4 (VDRAIN); also elsewhere on the board

Board: 2 copper layers, 116 parts (0 on the bottom side), 103 nets, no tracks yet.
