varunsunkara15/Nexus_drive/firmware/Comms Component Selection.ioc

Mcu.UserName=STM32G474METx
PA0.GPIO_Label=CURR_A
PA0.Signal=ADC1_IN1
PA10.Signal=S_TIM1_CH3
PA11.Signal=FDCAN1_RX
PA12.Signal=FDCAN1_TX
PA13.Signal=SYS_JTMS-SWDIO
PA14.Signal=SYS_JTCK-SWCLK
PA6.Signal=SPI1_MISO
PA7.Signal=TIM1_CH1N
PA8.Signal=S_TIM1_CH1
PA9.Signal=S_TIM1_CH2
PB1.Signal=TIM1_CH3N
PB12.Signal=TIM1_BKIN
PB13.Signal=SPI2_SCK
PB14.Signal=SPI2_MISO
PB15.Signal=SPI2_MOSI
PB3.Signal=SPI1_SCK
PB5.Signal=SPI1_MOSI
PC0.GPIO_Label=VPH_A
PC0.Signal=ADC1_IN6
PC1.GPIO_Label=VPH_B
PC1.Signal=ADC2_IN7
PC10.Signal=SPI3_SCK
PC11.Signal=SPI3_MISO
PC12.Signal=SPI3_MOSI
PC3.GPIO_Label=CURR_B
PC3.Signal=ADC2_IN9
PC4.GPIO_Label=GATE_EN
PC4.Signal=GPIO_Output
PC6.GPIO_Label=ENC1_CS
PC6.Signal=GPIO_Output
PC7.GPIO_Label=ENC2_CS
PC7.Signal=GPIO_Output
PC8.GPIO_Label=ENC3_CS
PC8.Signal=GPIO_Output
PC9.GPIO_Label=CAN_STB
PC9.Signal=GPIO_Output
PD10.Signal=GPIO_Output
PD8.GPIO_Label=TEMP_FET_LS
PD8.Signal=ADC4_IN12
PE10.Signal=TIM1_CH2N
PE11.GPIO_Label=TEMP_MOTOR
PE11.Signal=ADC4_IN15
PE12.Signal=SPI4_SCK
PE13.Signal=SPI4_MISO
PE14.Signal=SPI4_MOSI
PE15.GPIO_Label=VBUS
PE15.Signal=ADC4_IN2
PE7.GPIO_Label=VPH_C
PE7.Signal=ADC3_IN4
PE8.GPIO_Label=TEMP_FET_HS
PE8.Signal=ADC4_IN6
PE9.GPIO_Label=CURR_C
PE9.Signal=ADC3_IN2
PF0-OSC_IN.Signal=RCC_OSC_IN
PF1-OSC_OUT.Signal=RCC_OSC_OUT
