varunsunkara15/Nexus_drive/(commit log)

2026-10-23 Initial KiCad project for Nexus Drive humanoid motor driver
    [nexus_drive.kicad_pcb, nexus_drive.kicad_sch]
2026-10-26 Add power stage design notes and update README specs
2026-10-27 Add phase power section to schematic from moteus x1
    Three half-bridge sheets (FDMT80080DC pair, 0.5 mOhm shunt, Kelvin net
    ties, gate clamp, phase pad) and the 36x 4.7uF DC-link bank, copied from
    mjbots moteus hw/x1 (Apache-2.0) with attribution in NOTICE.md.
    [bulk_capacitance.kicad_sch, h_bridge.kicad_sch, nexus_drive.kicad_sch]
2026-10-27 Add DRV8353S gate driver and current-sense filter sheets from moteus x1
    Gate driver and current-sense RC sheets copied from mjbots moteus hw/x1
    (Apache-2.0). Root sheet moved to A3 and rewired; netlist matches moteus
    pin-for-pin for the driver and power stage.
    [current_sense.kicad_sch, gate_driver.kicad_sch, nexus_drive.kicad_sch]
2026-10-27 Remove DC-link capacitor bank; note bulk capacitance in README
    The ceramic DC-link bank is owned by another team member, so the Bulk
    Capacitance sheet is removed. README explains why bulk capacitance
    (electrolytic preferred over tantalum) is still needed.
    [bulk_capacitance.kicad_sch, nexus_drive.kicad_sch]
2026-10-28 Assign ADC pins: one ADC per phase, add TEMP_FET_LS, fix VPH_C
    [Comms Component Selection.ioc]
2026-10-28 Add STM32G474METx MCU sheet wired to the pin plan
    MCU sheet follows Comms Component Selection.ioc. Gate driver switched to
    6-PWM (INLA/B/C split from MOTOR_HIZ) to match TIM1 CHx/CHxN. Root nets
    renamed to the pin-plan names (PWM_xH/xL, GATE_EN, DRV_*, CURR_A/B/C).
    [gate_driver.kicad_sch, nexus_drive.kicad_sch, stm32g474.kicad_sch]
2026-10-28 MCU sheet edits: move VBUS to PA2, add USART3 on PE15/PB10
    Schematic files re-saved in KiCad 10 format. Ignore VS Code .history/.
    [current_sense.kicad_sch, gate_driver.kicad_sch, h_bridge.kicad_sch, nexus_drive.kicad_sch, stm32g474.kicad_sch]
2026-10-28 Fix MCU power wiring and add USART3 sheet pins
    Reconnect the +3V rail (shifted off the VBAT/VDDA stubs), add the missing
    VREF+ and VSS wires, and add USART3_TX/RX pins to the MCU sheet symbol.
    [nexus_drive.kicad_sch, stm32g474.kicad_sch]
2026-10-28 Reorganize repo: KiCad project in hardware/, CubeMX pin plan in firmware/
    [current_sense.kicad_sch, gate_driver.kicad_sch, h_bridge.kicad_sch, nexus_drive.kicad_pcb, nexus_drive.kicad_sch, stm32g474.kicad_sch]
2026-10-29 Add CAN FD and encoder sheets; update MCU sheet and root schematic
    [can_fd.kicad_sch, encoders.kicad_sch, nexus_drive.kicad_sch, stm32g474.kicad_sch]
2026-10-29 docs: add schematic review of the sheets drawn so far
    Review of the gate driver, H-bridge, current-sense, MCU, CAN-FD and
    encoder sheets at 779c08d, written for the deliberately over-specified
    (120 A-class) power stage. Includes what's done well and checklists of
    must-fix, should-fix and housekeeping items (R1-R19).
2026-10-29 Add sensing sheet; update MCU, CAN FD, encoder and root schematics
    [can_fd.kicad_sch, encoders.kicad_sch, nexus_drive.kicad_sch, sensing.kicad_sch, stm32g474.kicad_sch]
2026-10-30 Clean up schematic ERC; add project symbol library; update README
    Fix dangling labels, floating pins and pin types across the sheets so
    ERC reports 0 errors (see hardware/CHANGES.txt). Add PWR_FLAGs and move
    TCAN1042GV, MA702GQ and the EMI filter to nexus_drive.kicad_sym.
    Update the README layout, specs and schematic review status.
    [can_fd.kicad_sch, current_sense.kicad_sch, encoders.kicad_sch, gate_driver.kicad_sch, h_bridge.kicad_sch, nexus_drive.kicad_sch, sensing.kicad_sch, stm32g474.kicad_sch]
2026-11-02 Assign footprints on MCU, CAN and encoder sheets
    Assign footprints to 45 parts on stm32g474, can_fd and encoders.
    Add custom footprint L_CommonMode_TDK_ACT1210D for FL1 and register
    the nexus_drive footprint library in fp-lib-table.
    Swap pins 2 and 4 of the EMI_Filter_CommonMode symbol so windings are
    1-4 and 2-3, matching the new footprint. The ACT1210D land pattern and
    winding numbering still need checking against the TDK datasheet.
    [can_fd.kicad_sch, encoders.kicad_sch, stm32g474.kicad_sch]
2026-11-02 Add HC-05 connection on J1 and place footprints on PCB
    Extend J1 from 3 to 4 pins and add +5V so the HC-05 Bluetooth module
    can connect to USART3 (1 MCU TX, 2 MCU RX, 3 +5V, 4 GND).
    Import all 115 footprints into nexus_drive.kicad_pcb, unrouted. The PCB
    predates the J1 change and still has the 3-pin header, so it needs
    Update PCB from Schematic.
    [can_fd.kicad_sch, nexus_drive.kicad_pcb, stm32g474.kicad_sch]
2026-11-02 Rework J1 for direct HC-05 connection and update PCB
    Change J1 to a 2.54 mm 1x04 header to fit the HC-05 module and swap
    pins 3 and 4 so the order matches its RXD, TXD, GND, VCC pins
    (1 MCU TX, 2 MCU RX, 3 GND, 4 +5V). Update the schematic note.
    Replace J1 on the PCB with the 4-pin footprint and move it clear of
    Q3. Schematic parity check now reports no issues.
    [nexus_drive.kicad_pcb, stm32g474.kicad_sch]
2026-11-03 README: replace schematic review with 3 Nov 2026 review
    Review of commits 5576cbb, c29ffc7, 5195f6f and the sensing sheet.
    Items N1-N19; open items from the 29 Oct review carried over.
2026-11-03 Merge external connectors into J3 and J5; add input protection
    The mechanical design allows only two external connectors:
    - J3 (JST-PH 8-pin): CAN in on pins 1-3, CAN out on 4-6, motor NTC on 7-8.
    Replaces J4 and J7.
    - J5 (JST-PH 12-pin): encoder port 2 on pins 1-6, port 1 on 7-12.
    Replaces J6.
    Details in hardware/CHANGES_connectors.txt.
    Review fixes on the MCU, CAN, encoder and sensing sheets:
    - N7: D7 ESD diode to GNDA and R39 1k in series on the motor NTC input
    (J3 pin 7). Firmware must subtract 1k from the NTC reading.
    - N12: PTC fuses F1/F2 on encoder port power (J5 pins 1 and 7).
    - N11: thermistor pull-ups R27/R31/R35 moved to +3VA.
    - N14: nexus_drive added to sym-lib-table.
    PC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
    [can_fd.kicad_sch, encoders.kicad_sch, nexus_drive.kicad_pcb, nexus_drive.kicad_sch, sensing.kicad_sch]
